BY2HIT/usdx-arduino/Hardware/README.md

## 0.2.1 20210815
### uSDX-IO
1. 调整接地通孔位置
### uSDX-RF
1. 修正SMA引脚间距
2. RF和ANT间增加电容位置，不装低通时使用
3. 调整Q1~Q3焊盘大小
4. 调整接地通孔位置

## 0.2.0 20210813
### uSDX-IO
1. 修正OLED屏幕引脚顺序
2. OLED I2C接至PD2 (SDA)、PD3 (SCL)
3. 删除K口，更换为两个3.5mm接口，分别用于MIC+PTT接口和电键接口
4. 增加MIC选择跳线，MIC选择逻辑为：MIC+PTT接口插入时，使用外部MIC；MIC+PTT接口未插入时，使用跳线选择板上MIC或耳机MIC
5. 钽电容更换为大容量陶瓷
6. 调整位置排针与Arduino板完全对齐
7. 丝印增加按钮开关功能说明
8. 更换为小logo，补充板名、版本号
9. 编码器更换为带定位的型号
### uSDX-RF
1. 修正BOM中R6型号错误，应为10k
2. 修正BOM中X1型号错误，应有源晶振
3. 修正L1、C21与Arduino板USB干涉，调整L1位置并去掉C21
4. 钽电容更换为大容量陶瓷
5. 调整位置排针与Arduino板完全对齐
6. Q1~Q3焊盘更换间距较大封装
7. 更换为小logo，补充板名、版本号
