BY2HIT/usdx-arduino/(threads)

Thread 1 (2021-08-19):

20210806问题解决了么？  我要冲

SparkCD, 2021-08-19:
有没有群啊？ 我还是喜欢三明治结构的

bg2bhc, 2021-08-19:
应该都改过来了，文件已经更新了，不过我们的新样机还没回来。暂时没有搞群。

SparkCD, 2021-08-20:
为什么屏幕I2c接到io那边去了？ 还可以io模拟i2c的嘛？   UNO SDA SDL不是A4 A5口么？  而且线也太靠外了。。。

Kerry-Huang, 2021-08-20:
原版程序OLED的确是模拟I2C，第一版样机就被这个坑了。。。
走线的确有不合理之处，等第二版样机回来后可以再优化一下

SparkCD, 2021-08-20:
好的  机器很漂亮   就冲这个了~

Closed 2021-08-20.

Thread 2 (2021-08-21):

这里的高频电感哪里买？

SparkCD, 2021-08-21:
T37-6 T37-2铁芯       5，8，9，12，15匝         80，190，240，430，680 nh 这几个关键词都找不到成品   立创也没有

bg2bhc, 2021-08-21:
买磁芯然后用漆包线自己绕，T37-2/6是磁芯型号

SparkCD ***@***.***> 於 2021年8月21日 週六 上午8:40寫道：

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

siuze, 2022-01-22:
> 买磁芯然后用漆包线自己绕，T37-2/6是磁芯型号 SparkCD ***@***.***> 於 2021年8月21日 週六 上午8:40寫道：
> […](#)
> T37-6 T37-2铁芯 5，8，9，12，15匝 80，190，240，430，680 nh 这几个关键词都找不到成品 立创也没有 — You are receiving this because you are subscribed to this thread. Reply to this email directly, view it on GitHub <#2>, or unsubscribe <https://github.com/notifications/unsubscribe-auth/AAV5NATVHXOMQHLEE3ZKK33T53YWZANCNFSM5CRIENHA> . Triage notifications on the go with GitHub Mobile for iOS <https://apps.apple.com/app/apple-store/id1477376905?ct=notification-email&mt=8&pt=524675> or Android <https://play.google.com/store/apps/details?id=com.github.android&utm_campaign=notification-email> .

请问漆包线的直径有要求吗？

bg2bhc, 2022-01-23:
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

尽量用粗点的就行

Closed 2021-08-21.

Thread 4 (2021-10-08):

您好，原理图上电容C21、C37的容值没有标明

ns123, 2021-10-08:
如题

BG6TNB, 2023-03-04:
您好，请问 C21、C37 两颗电容是可以不装么？如果需要装的话，容值您现在知道了么？

bg2bhc, 2023-03-05:
你好 ，这两个电容位置是预留的  ，完全按我们提供的图纸做这两个电容不装就可以了

BG6TNB ***@***.***> 於 2023年3月4日 週六 下午8:49寫道：

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

BG6TNB, 2023-03-05:
非常感谢您在百忙之中的回复，我已经明白复刻不需要安装这两颗电容了。如果可以方便给我一点关键字，我去查一下这两个预留电容是做什么的、在系统中起什么作用么？最后非常感谢您在开源领域做出的贡献，感恩。在 2023年3月5日，16:42，bg2bhc ***@***.***> 写道：
你好 ，这两个电容位置是预留的  ，完全按我们提供的图纸做这两个电容不装就可以了

BG6TNB ***@***.***> 於 2023年3月4日 週六 下午8:49寫道：

> 您好，请问 C21、C37 两颗电容是可以不装么？如果需要装的话，容值您现在知道了么？

>

> —

> Reply to this email directly, view it on GitHub

> <https://github.com/BY2HIT/usdx-arduino/issues/4#issuecomment-1454729331>,

> or unsubscribe

> <https://github.com/notifications/unsubscribe-auth/AAV5NAQPSSKSPCACL7J5P7LW2M27BANCNFSM5FTYDAWQ>

> .

> You are receiving this because you are subscribed to this thread.Message

> ID: ***@***.***>

>

—Reply to this email directly, view it on GitHub, or unsubscribe.You are receiving this because you commented.Message ID: ***@***.***>

bg2bhc, 2023-03-06:
您好，C21可以跳过低通滤波器，对于一些只需要接收并且需要降低成本的场合，可以低通和继电器都不装，只要装了C21就仍然可以接收。C37是低通滤波器的一部分，有的频段的滤波器需要用非标准的电容值，这就需要两个电容并联，C37所在的频段不需要并联。

BG6TNB ***@***.***> 於 2023年3月5日 週日 下午7:16寫道：

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

BG6TNB, 2023-03-07:
学习了，非常感谢您的回复。73在 2023年3月6日，10:00，bg2bhc ***@***.***> 写道：
您好，C21可以跳过低通滤波器，对于一些只需要接收并且需要降低成本的场合，可以低通和继电器都不装，只要装了C21就仍然可以接收。C37是低通滤波器的一部分，有的频段的滤波器需要用非标准的电容值，这就需要两个电容并联，C37所在的频段不需要并联。

BG6TNB ***@***.***> 於 2023年3月5日 週日 下午7:16寫道：

> 非常感谢您在百忙之中的回复，我已经明白复刻不需要安装这两颗电容了。如果可以方便给我一点关键字，我去查一下这两个预留电容是做什么的、在系统中起什么作用么？最后非常感谢您在开源领域做出的贡献，感恩。在

> 2023年3月5日，16:42，bg2bhc ***@***.***> 写道：

> 你好 ，这两个电容位置是预留的 ，完全按我们提供的图纸做这两个电容不装就可以了

>

>

>

> BG6TNB ***@***.***> 於 2023年3月4日 週六 下午8:49寫道：

>

>

>

> > 您好，请问 C21、C37 两颗电容是可以不装么？如果需要装的话，容值您现在知道了么？

>

> >

>

> > —

>

> > Reply to this email directly, view it on GitHub

>

> > <https://github.com/BY2HIT/usdx-arduino/issues/4#issuecomment-1454729331

> >,

>

> > or unsubscribe

>

> > <

> https://github.com/notifications/unsubscribe-auth/AAV5NAQPSSKSPCACL7J5P7LW2M27BANCNFSM5FTYDAWQ

> >

>

> > .

>

> > You are receiving this because you are subscribed to this thread.Message

>

> > ID: ***@***.***>

>

> >

>

>

>

> —Reply to this email directly, view it on GitHub, or unsubscribe.You are

> receiving this because you commented.Message ID: ***@***.***>

>

> —

> Reply to this email directly, view it on GitHub

> <https://github.com/BY2HIT/usdx-arduino/issues/4#issuecomment-1455061214>,

> or unsubscribe

> <https://github.com/notifications/unsubscribe-auth/AAV5NAURL3ANOI5RI443VD3W2RYYJANCNFSM5FTYDAWQ>

> .

> You are receiving this because you commented.Message ID:

> ***@***.***>

>

—Reply to this email directly, view it on GitHub, or unsubscribe.You are receiving this because you commented.Message ID: ***@***.***>

Closed 2021-10-09.

Thread 5 (2022-10-14):

Does there have gerber files?

kevinl8890, 2022-10-14:

bg2bhc, 2022-10-14:
Sorry but we did not export gerber files. Maybe you can use LCEDA to export them.

kevinl8890, 2022-10-14:
On the other hand, do you sell complete PCBs with components?

bg2bhc, 2022-10-14:
> On the other hand, do you sell complete PCBs with components?

No such plan yet.

Closed 2023-03-31.

Thread 7 (2023-04-03):

换玩BS170还是没有声音-87dbm

ZhouChangwei88, 2023-04-03:
一开始用的BS170么管脚定义是反的，焊上去后12V电压直接掉到3V后来正过来装BS170后短路问题解决了，但是只有嘀嗒嘀嗒的噪音，且一直信号强度一直是-87dbm左右，接天线后依然如此，无任何改善，不知道是否有遇到同样问题的友台。

bg2bhc, 2023-04-03:
BS170和接收没关系，不装应该也能正常接收，可能得查查其他地方

ZhouChangwei88 ***@***.***> 於 2023年4月3日 週一 下午3:25寫道：

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

ZhouChangwei88, 2023-04-03:
请问是否有各芯片标准信号参考波形，我现在即使用示波器测试也不知道芯片的输出应该是什么样的

Thread 8 (2023-08-18):

请教一下 OLED 屏幕的 IIC 为什么连接到 D2、D3 引脚？

zipeijun, 2023-08-18:
我查看了 IO 和 RF 两块板子的接线，发现 OLED IIC 链接在 D2、D3 而不是 UNO 的 SDA、SCL 上面，也没有跨板的走线，请问这是个什么原理？UNO 貌似不支持 ESP32 那样的引脚矩阵？

这是 IO 板 PCB 部分截图：
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

这是 RF 板 PCB 部分截图：
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

zipeijun, 2023-08-18:
我猜一下，是不是代码中使用了软件 IIC ？

zipeijun, 2023-08-18:
虽然还没有完全弄明白，不过代码中是这么要求的，这么看来不是硬件画错了。

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

zipeijun, 2023-08-28:
弄明白了，回答下自己的疑惑。

硬件 IIC 用于驱动 SI5351，要求较高所以使用硬件 IIC；OLED 更新画面要求不那么高所以使用的软件实现的 IIC。

Closed 2023-08-18.

Thread 9 (2023-09-05):

添加菜单的问题

www97221, 2023-09-05:
谢谢我有一个问题:我想使用您的评论添加一个项目到菜单:# define N PARAMS 44+4//(可见)参数的数量//可见菜单项和enum参数也修改开关(id){//可见参数
case ADD完成后，USDX中新添加的菜单项显示乱码。把菜单加在最后就是乱码，加在中间位置就不乱码，我不知道问题出在哪里

Closed 2023-09-06.
