BY2HIT/usdx-arduino/Hardware/0.2.1 20210815/uSDX-IO/Schematic_USDX-IO_0.2.1.pdf

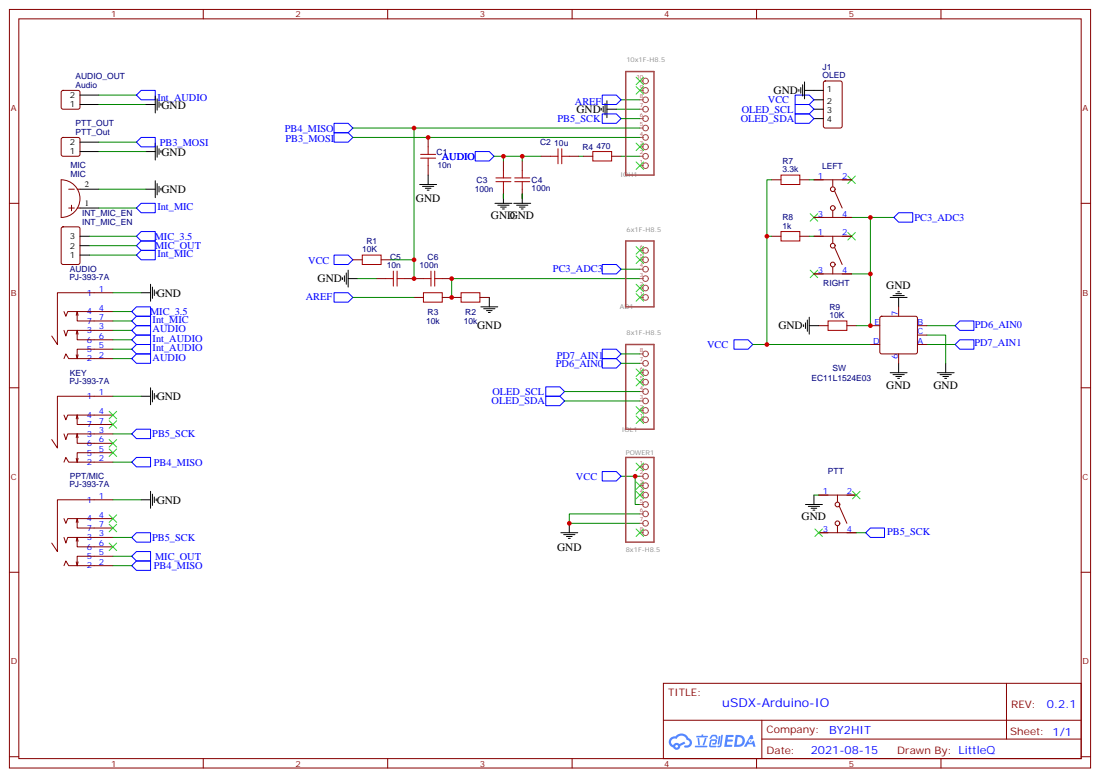
[picture p1: page 1]
