BY2HIT/usdx-arduino/Hardware/0.2.1 20210815/uSDX-RF/Schematic_USDX-RF_0.2.1.pdf

# SI5351A

# FST3253/LM4562

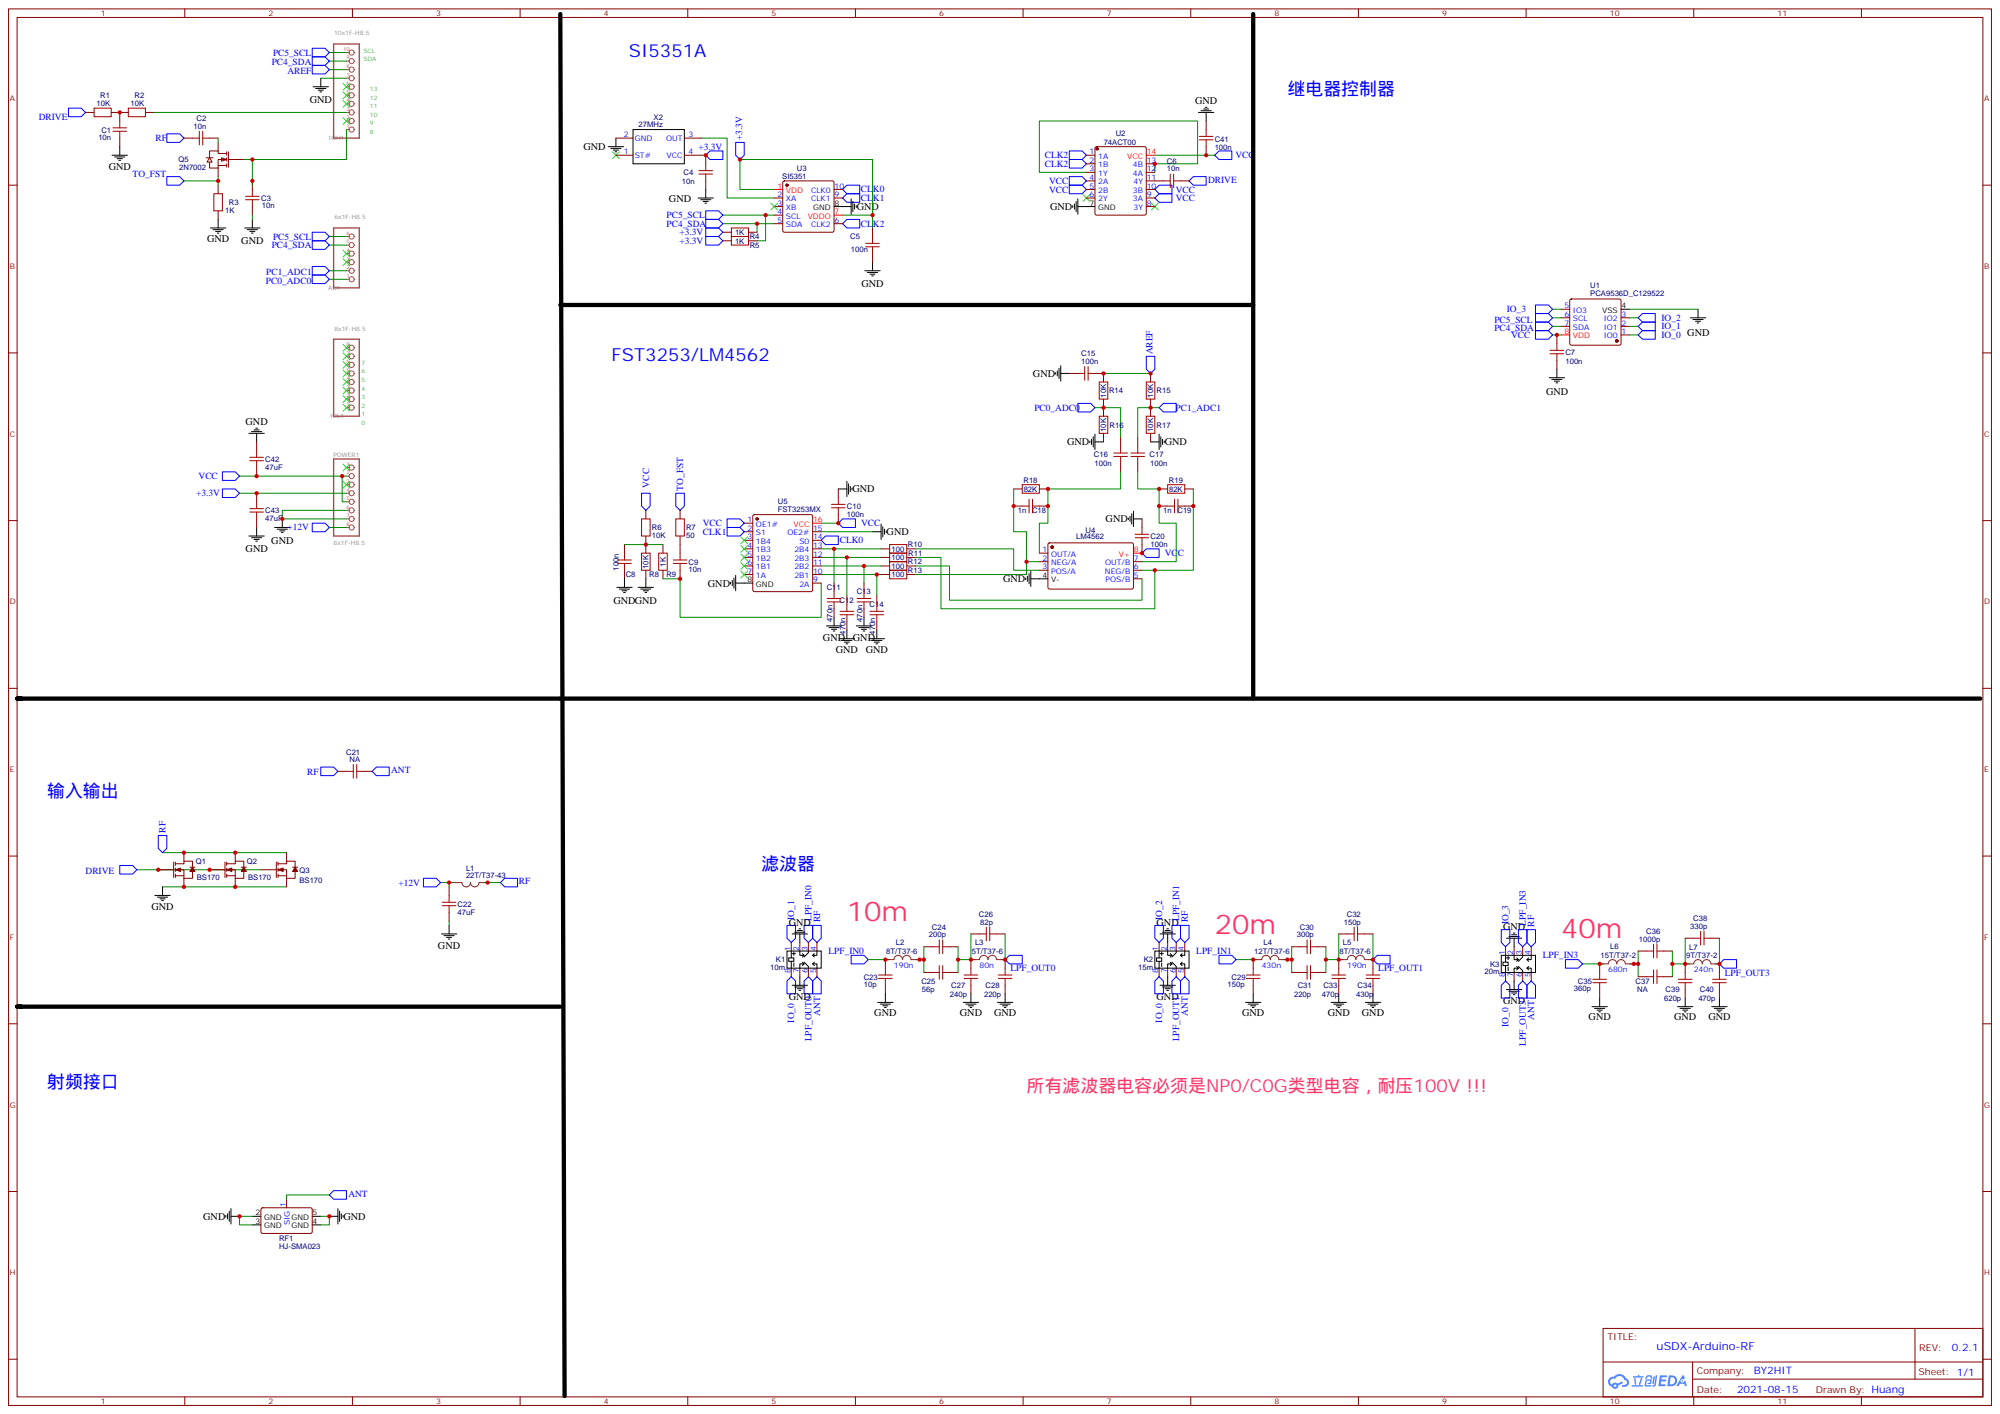
[picture p2: page 1]
