BY2HIT/usdx-arduino/(commit log)

2021-06-15 add arduino sch
2021-08-03 Update PCB
2021-08-15 Update PCB & add changelog
